popradu10/pop-radu-diy-injector-ecu-piggyback/docs/arduino-idee-esp32 v2.x.jpg

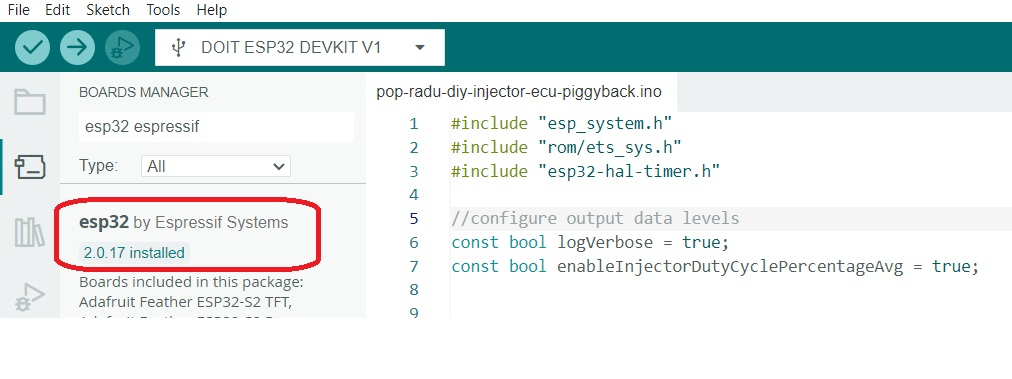
docs/arduino-idee-esp32 v2.x.jpg
