popradu10/pop-radu-diy-injector-ecu-piggyback/docs/diy_injector_piggyback_a.jpg

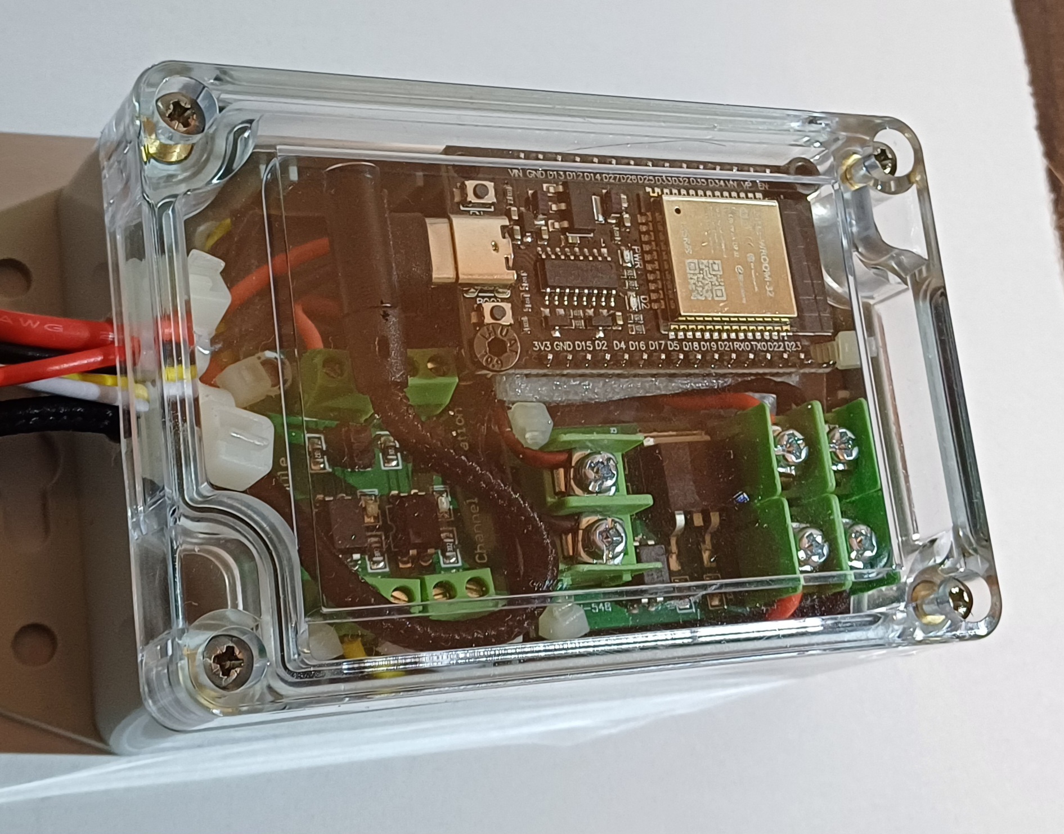
docs/diy_injector_piggyback_a.jpg
