popradu10/pop-radu-diy-injector-ecu-piggyback/docs/diy_injector_piggyback_arduino_micro_4.jpg

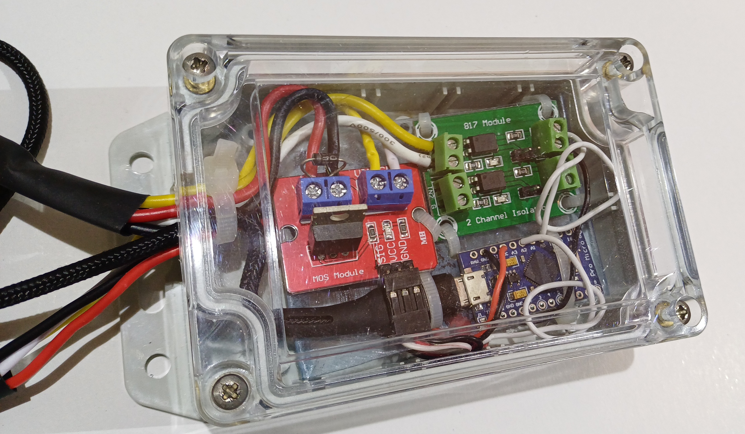
docs/diy_injector_piggyback_arduino_micro_4.jpg
