popradu10/pop-radu-diy-injector-ecu-piggyback/docs/diy_injector_piggyback_arduino_micro_5.jpg

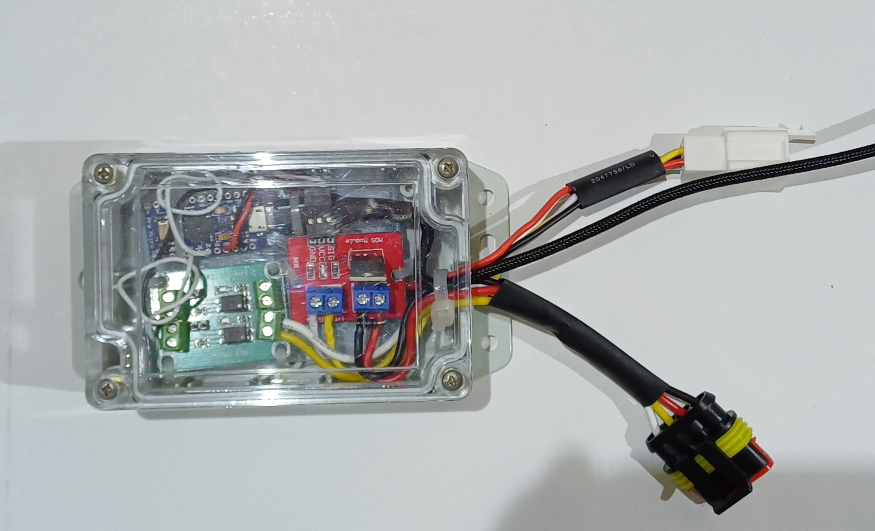
docs/diy_injector_piggyback_arduino_micro_5.jpg
