popradu10/pop-radu-diy-injector-ecu-piggyback/docs/diy_injector_piggyback_b.jpg

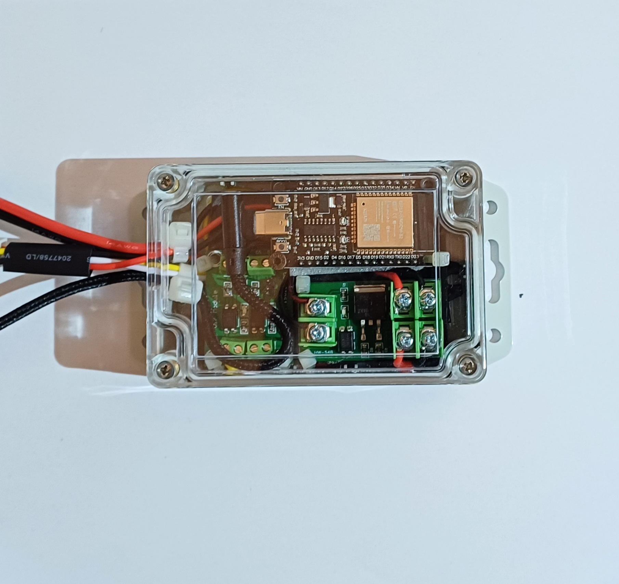
docs/diy_injector_piggyback_b.jpg
