popradu10/pop-radu-diy-injector-ecu-piggyback/docs/mosfet.jpg

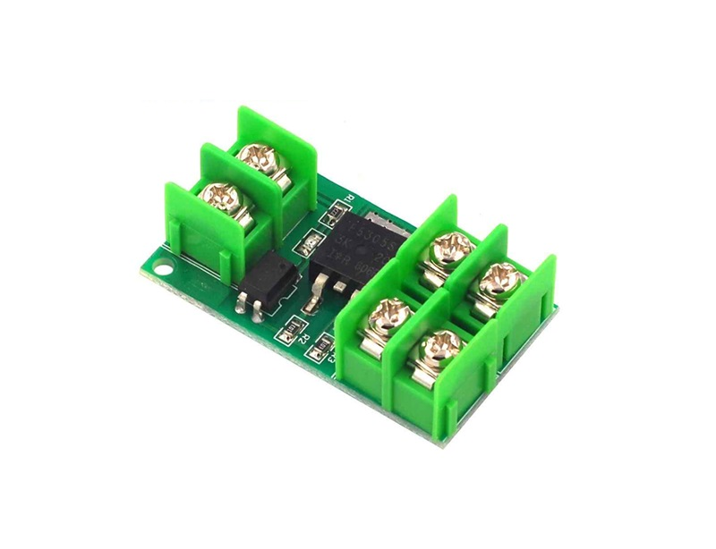
docs/mosfet.jpg
