popradu10/pop-radu-diy-injector-ecu-piggyback/docs/osciloscop_80_dut_20250203.jpg

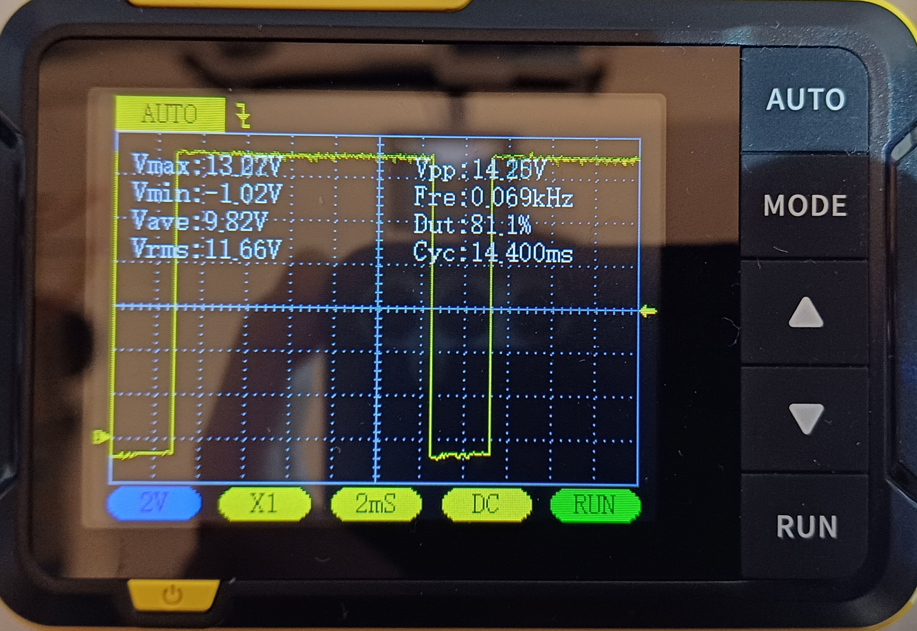
docs/osciloscop_80_dut_20250203.jpg
