popradu10/pop-radu-diy-injector-ecu-piggyback/docs/RPM-computed-based-on-INJ-Output-june-2024.png

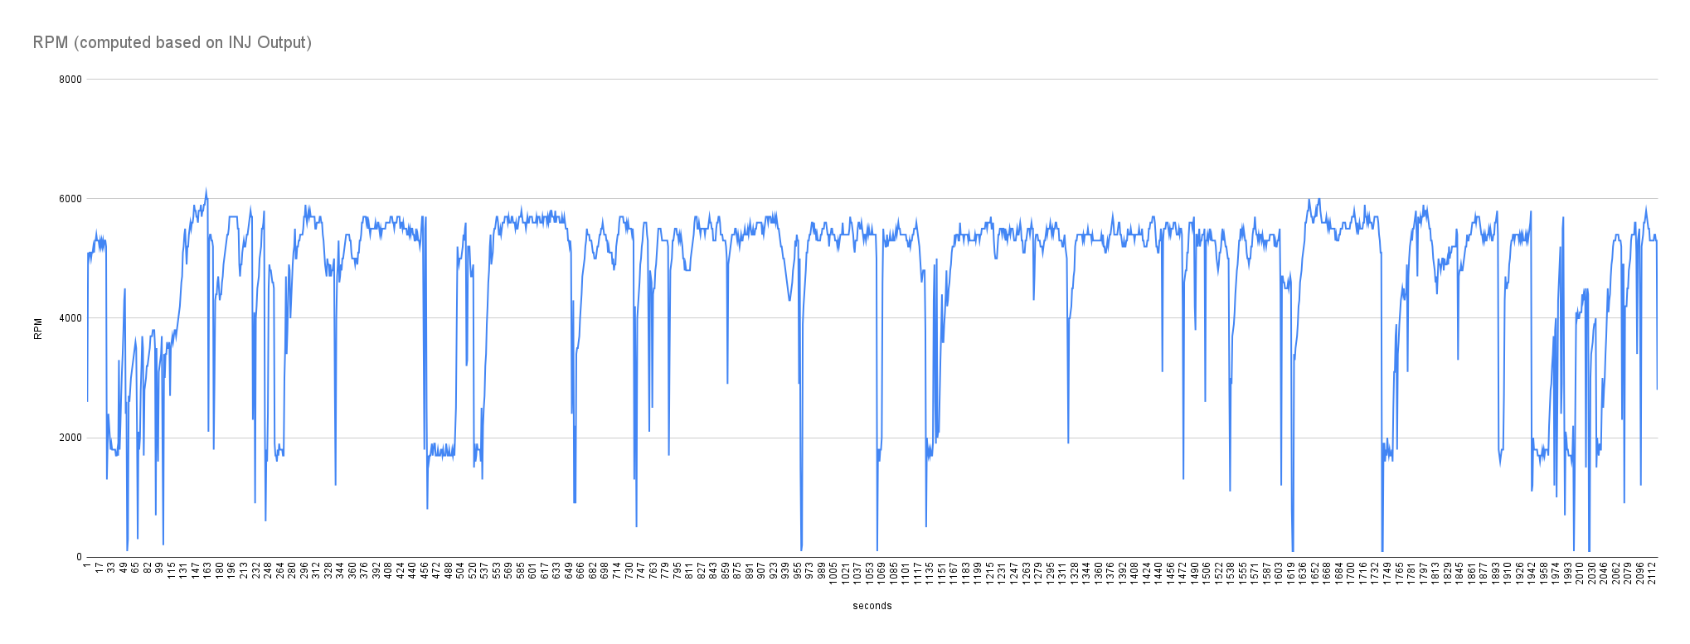
docs/RPM-computed-based-on-INJ-Output-june-2024.png
