popradu10/pop-radu-diy-injector-ecu-piggyback/docs/start_50cc_engine_on_vs_off_injector_milliseconds.jpg

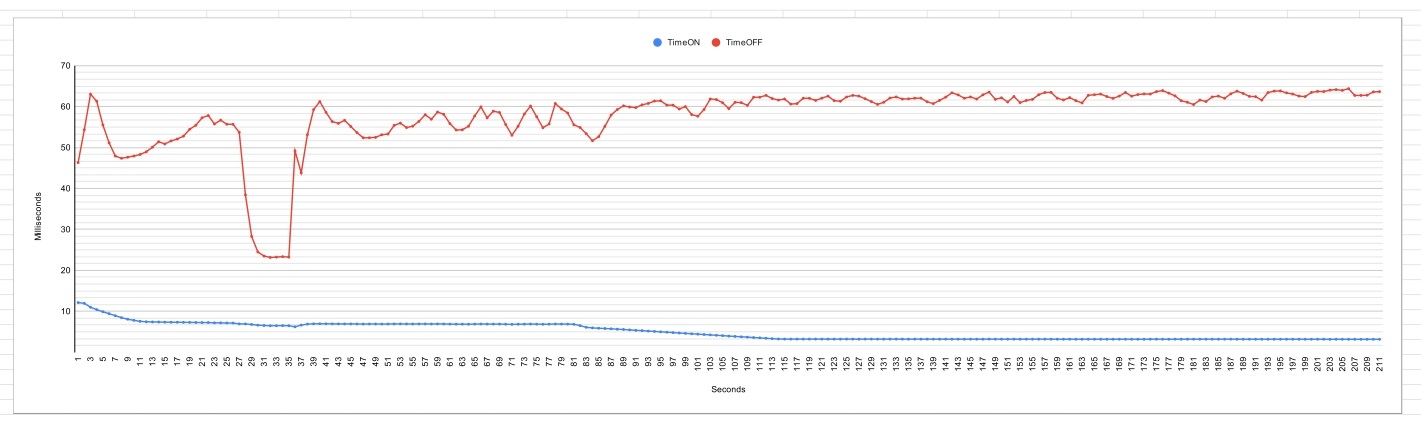
docs/start_50cc_engine_on_vs_off_injector_milliseconds.jpg
