popradu10/pop-radu-diy-injector-ecu-piggyback/site-builder/template.html

- Home
- Presentation
- Videos

HOME_PLACEHOLDER_CONTENT

PRESENTATION_PLACEHOLDER_CONTENT

VIDEO_PLACEHOLDER_CONTENT

© Pop Radu. DIY Piggyback for Electric Fuel Injector Engines. Released under the MIT License (https://raw.githubusercontent.com/popradu10/pop-radu-diy-injector-ecu-piggyback/main/LICENSE.txt). View on GitHub (https://github.com/popradu10/pop-radu-diy-injector-ecu-piggyback).
