popradu10/pop-radu-diy-injector-ecu-piggyback/site-builder/video.html

# Youtube

# TikTok

@pop.radu.moto.50cc (https://www.tiktok.com/@pop.radu.moto.50cc?refer=embed)

@pop.radu.moto.50cc (https://www.tiktok.com/@pop.radu.moto.50cc?refer=embed)
