popradu10/pop-radu-diy-injector-ecu-piggyback/docs/Injector-duty-cycle-45-piggyback-setup-june-2024.png

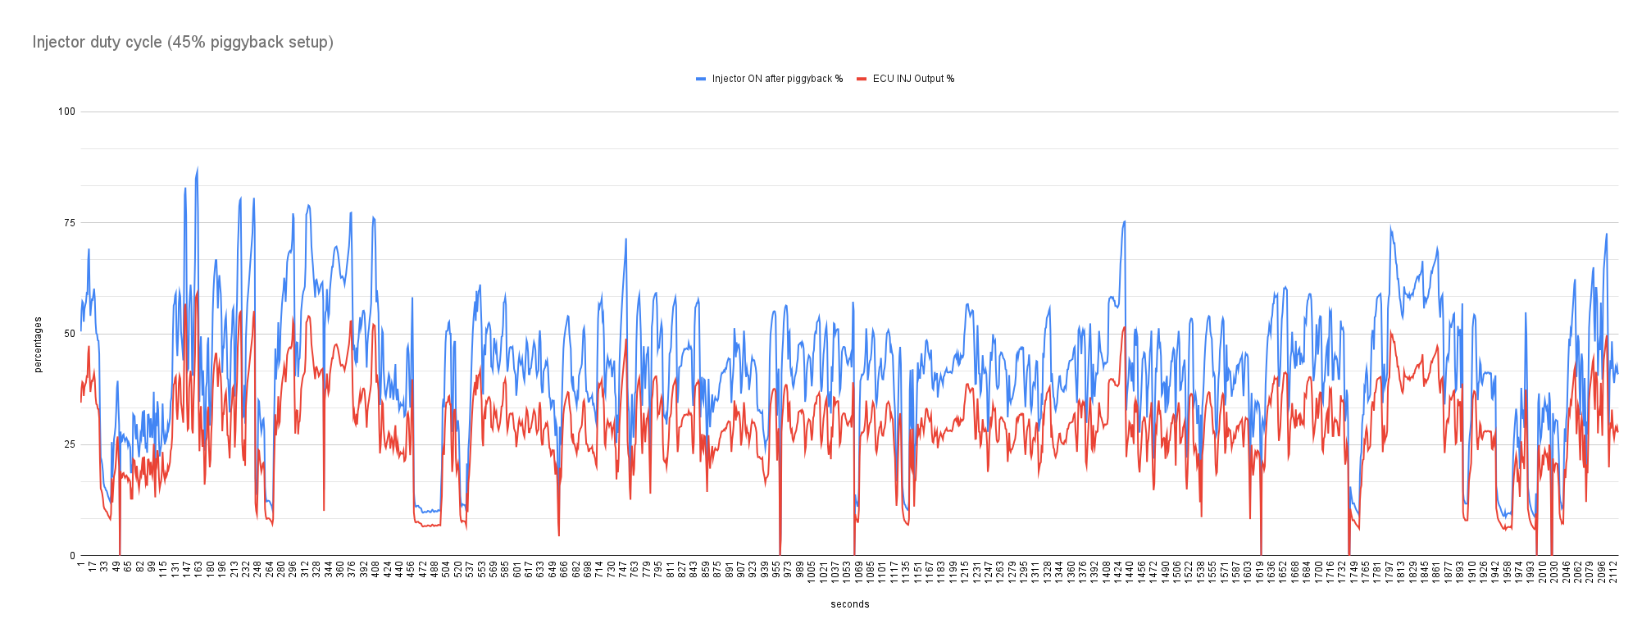
docs/Injector-duty-cycle-45-piggyback-setup-june-2024.png
