popradu10/pop-radu-diy-injector-ecu-piggyback/(commit log)

2024-09-30 start using timer1 and 0.01 milliseconds
2024-10-03 IRF520 MOSFET Driver Module
2024-10-21 add datalog_oct_2024_50cc_0increase.csv
    [datalog_oct_2024_50cc_0increase.csv]
2024-10-22 add Circuit Diagram
2024-11-09 code tested on the road
    [datalog_20241109.csv]
2024-11-10 add Arduino code Flow Diagram
2024-12-04 menu for mobile devices
2025-01-18 simpler serial outpur and fix rpm computation
    [diy-injector-ecu-piggyback.ino]
2025-01-20 reset timer trigget also at timer reset
    [diy-injector-ecu-piggyback.ino]
2025-01-22 fix bug for warning increase condition
    [diy-injector-ecu-piggyback.ino]
